thejiral/toh-designs_cTOH-M/README.md

TOH designs repository
======================
This repository is for sharing TOH designs, like 3D models, CAD drawings and schematics.

Files for Official Jolla TOHs can be found in [jolla subdirectory](jolla/).
