thejiral/toh-designs_cTOH-M/cTOH-M/IMG/IMG_2407.jpg

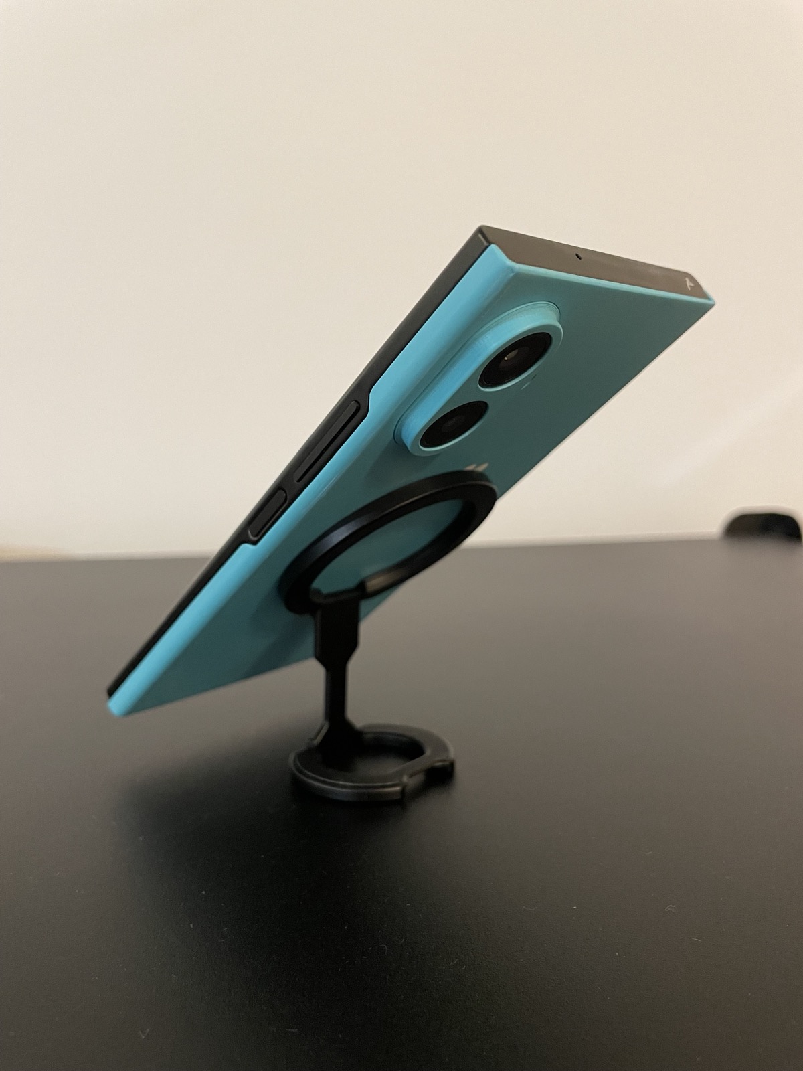
cTOH-M/IMG/IMG_2407.jpg
