thejiral/toh-designs_cTOH-M/cTOH-M/IMG/IMG_2410.jpg

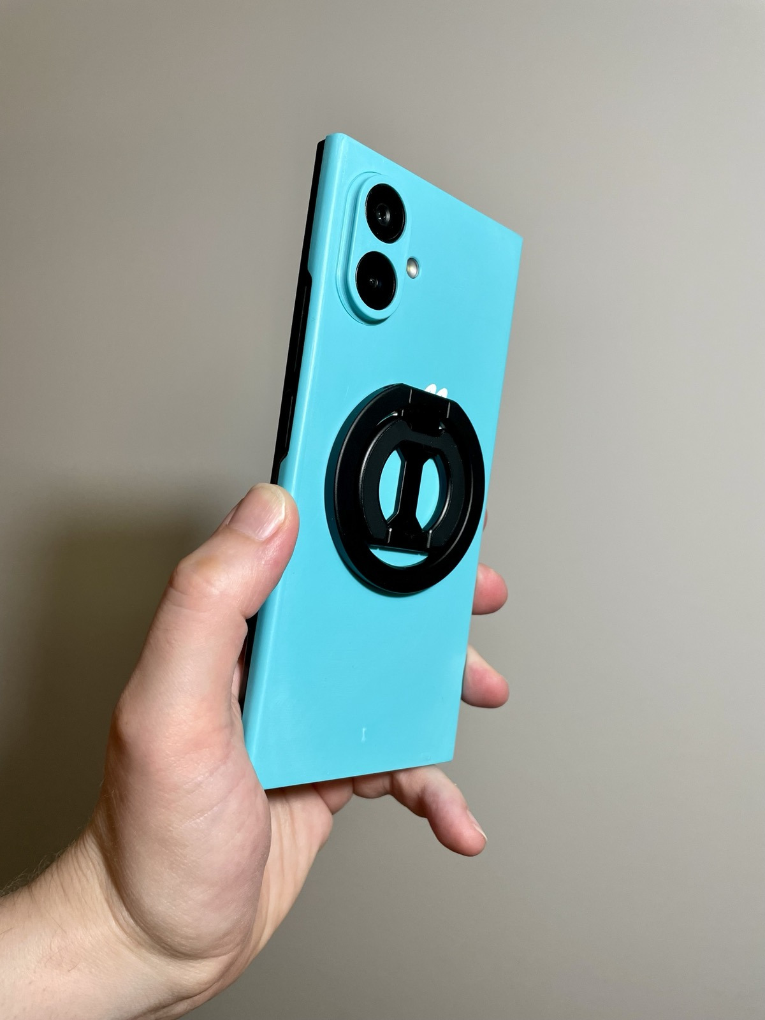
cTOH-M/IMG/IMG_2410.jpg
