thejiral/toh-designs_cTOH-M/cTOH-M/1-frame-final1.step

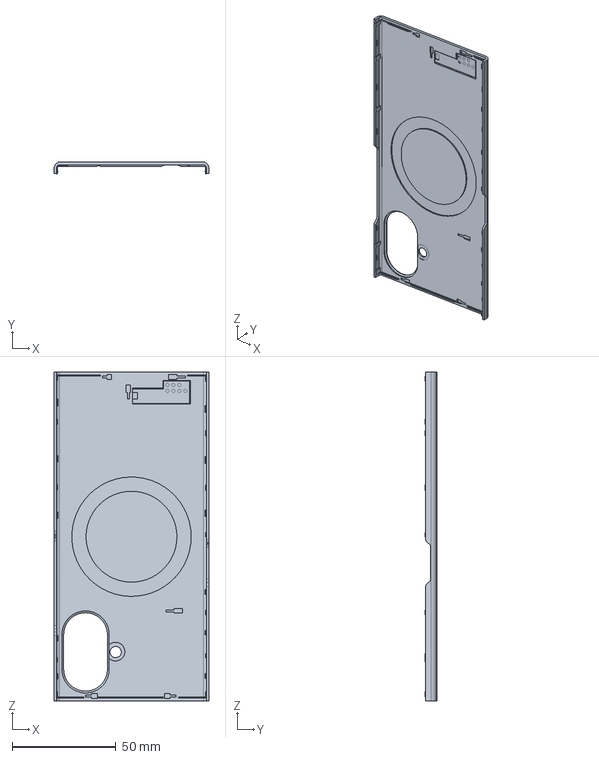
[picture p4: CAD file, 2026-08-23]
cTOH-M/1-frame-final1.step
74.4 x 5.71 x 158.2 mm
