thejiral/toh-designs_cTOH-M/cTOH-M/Individual_clip_files/frame-p8-c3.step

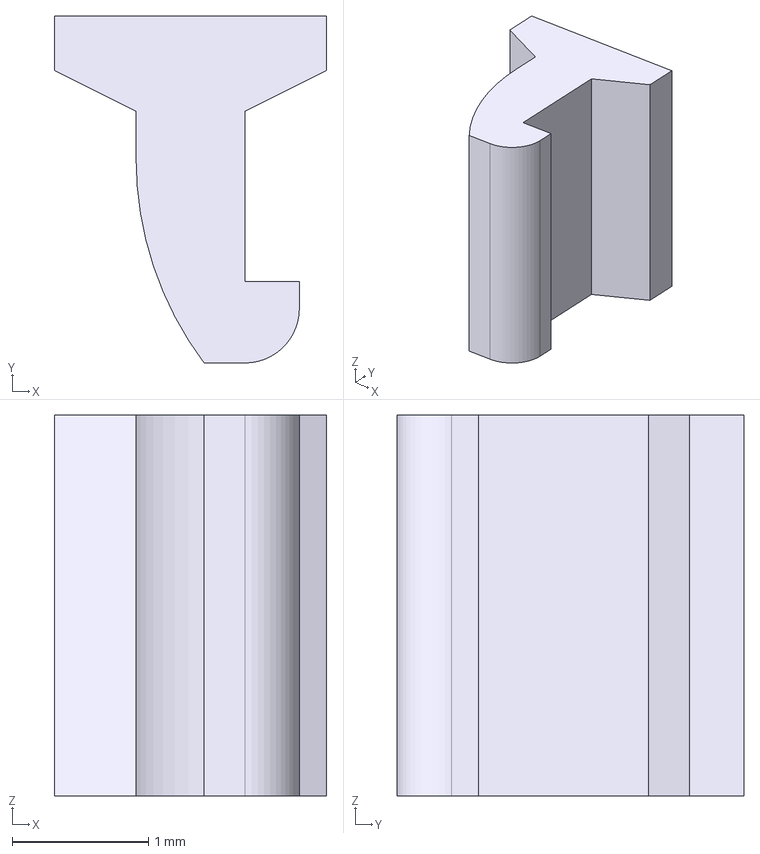
[picture p5: CAD file, 2026-08-23]
cTOH-M/Individual_clip_files/frame-p8-c3.step
2.00 x 2.55 x 2.80 mm
