thejiral/toh-designs_cTOH-M/jolla/toh-3d-model.step

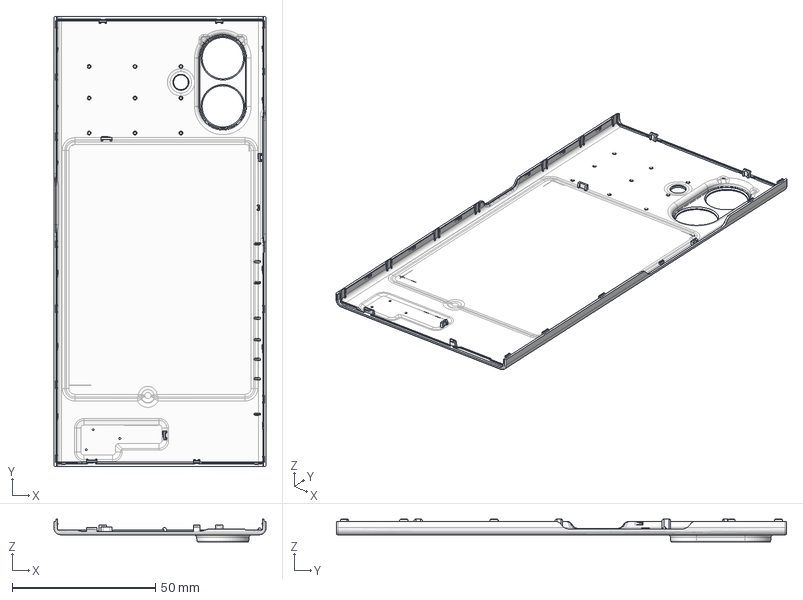
[picture p6: CAD file, 2026-08-12]
jolla/toh-3d-model.step
73.9 x 156.9 x 7.92 mm
