thejiral/toh-designs_cTOH-M/cTOH-M/2-Bump-Final2_with_integrated_supports.step

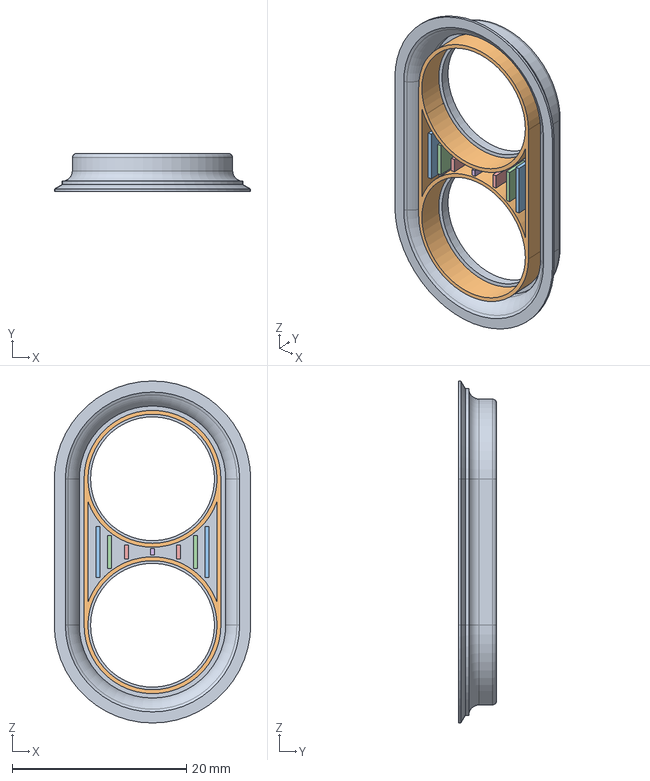
[picture p7: CAD file, 2026-08-23]
cTOH-M/2-Bump-Final2_with_integrated_supports.step
22.5 x 4.40 x 39.2 mm
