thejiral/toh-designs_cTOH-M/cTOH-M/Individual_clip_files/frame-p8-c2.step

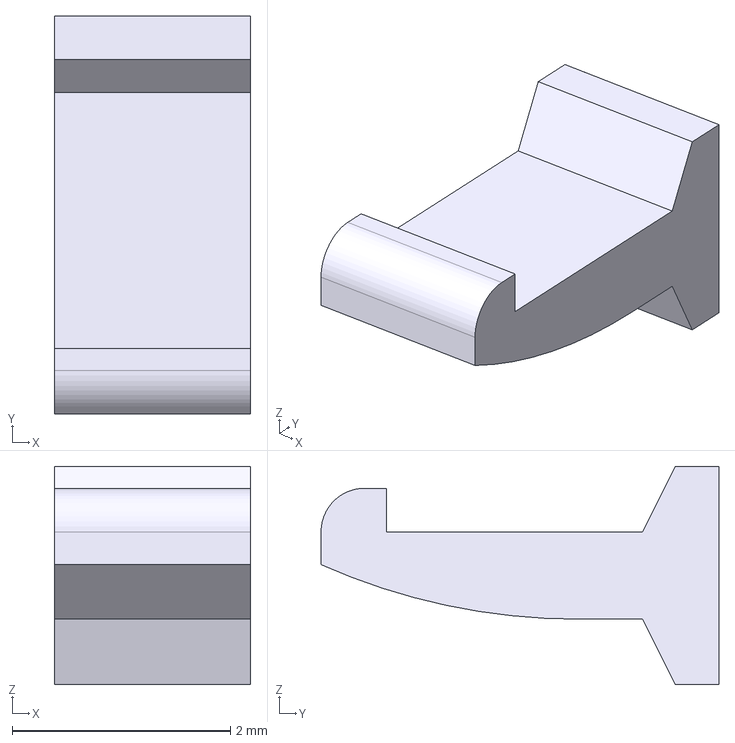
[picture p8: CAD file, 2026-08-23]
cTOH-M/Individual_clip_files/frame-p8-c2.step
1.80 x 3.65 x 2.00 mm
