thejiral/toh-designs_cTOH-M/cTOH-M/Individual_clip_files/frame-p8-c6.step

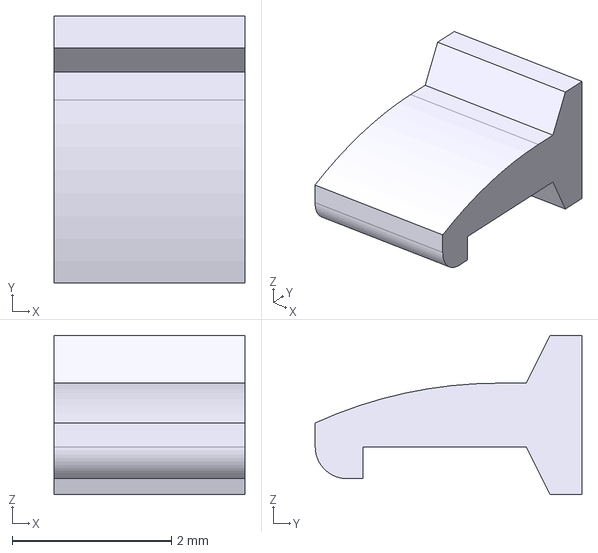
[picture p9: CAD file, 2026-08-23]
cTOH-M/Individual_clip_files/frame-p8-c6.step
2.40 x 3.35 x 2.00 mm
