thejiral/toh-designs_cTOH-M/cTOH-M/Optional_Clips.3mf

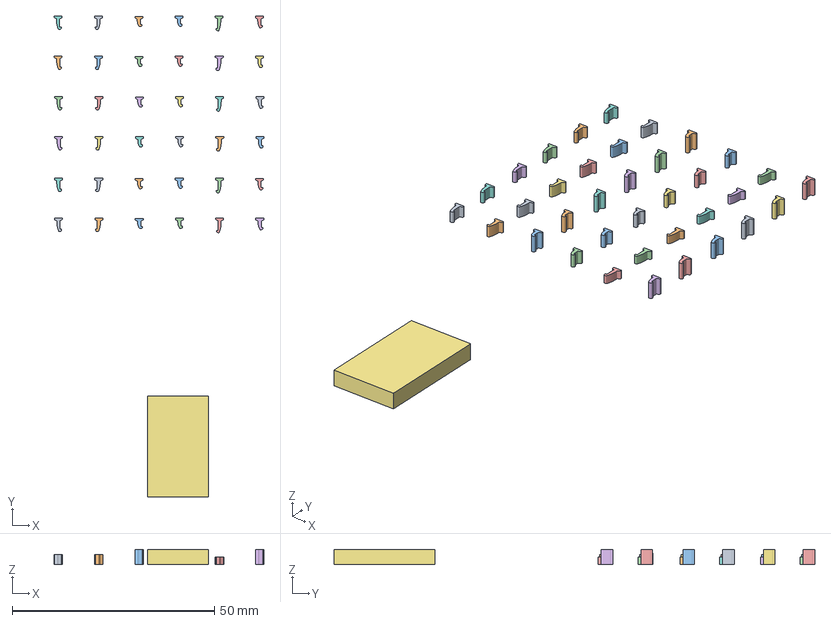
[picture p10: CAD file, 2026-08-23]
cTOH-M/Optional_Clips.3mf
51.9 x 118.9 x 3.60 mm
Frame-P8-C7 x 6
Frame-P8-C6 x 6
Frame-P8-C5 x 6
Frame-P8-C3 x 6
Frame-P8-C2 x 6
Frame-P8-C1 x 6
Shape-Box
