thejiral/toh-designs_cTOH-M/cTOH-M/Individual_clip_files/frame-p8-c5.step

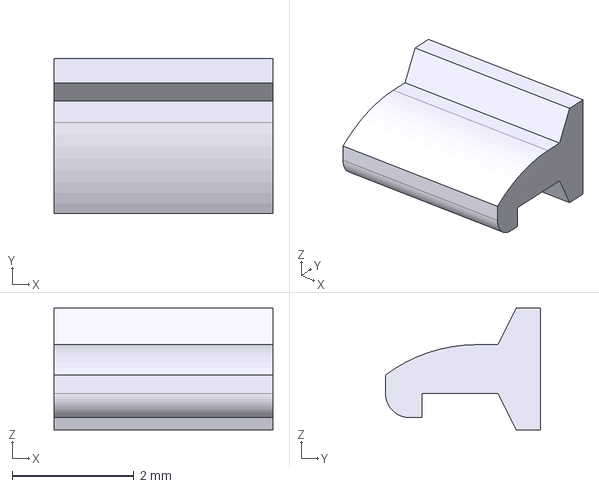
[picture p11: CAD file, 2026-08-23]
cTOH-M/Individual_clip_files/frame-p8-c5.step
3.60 x 2.55 x 2.00 mm
