thejiral/toh-designs_cTOH-M/cTOH-M/Optional_Frame-Final1-no sanding.step

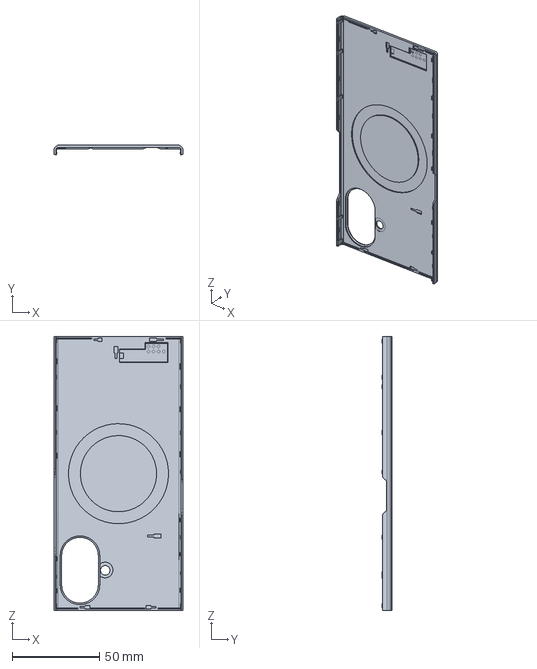
[picture p12: CAD file, 2026-08-23]
cTOH-M/Optional_Frame-Final1-no sanding.step
74.0 x 5.71 x 157.2 mm
