thejiral/toh-designs_cTOH-M/cTOH-M/Individual_clip_files/frame-p8-c1.step

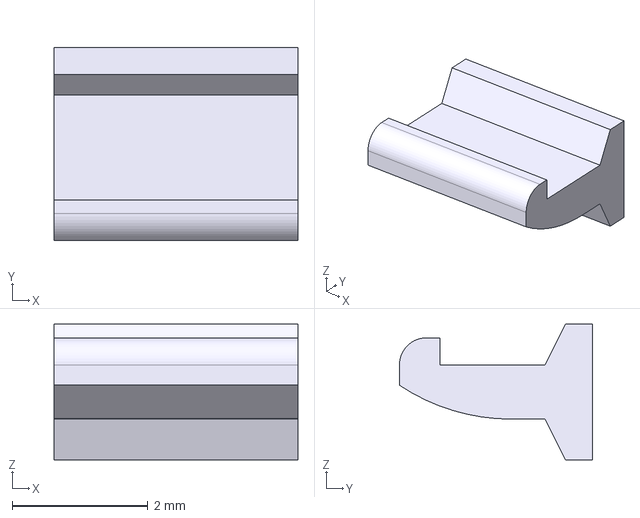
[picture p13: CAD file, 2026-08-23]
cTOH-M/Individual_clip_files/frame-p8-c1.step
3.60 x 2.85 x 2.00 mm
