thejiral/toh-designs_cTOH-M/(list of files, cad)

Other CAD files:
cTOH-M/Individual_clip_files/frame-p8-c7.step
